b4ck5p4c3/lambium/README.md

# Lambium

Monorepo for weird building control and automation devices we built in B4CKSP4CE.

## License

- Hardware designs are licensed under the CERN Open Hardware Licence Version 2 - Strongly Reciprocal (CERN-OHL-S-2.0).
- Software is licensed under the Mozilla Public License 2.0.
