b4ck5p4c3/lambium/LAM-4I4O/hardware/LAM-4I4O-REVC/LAM-4I4O-REVC.pdf

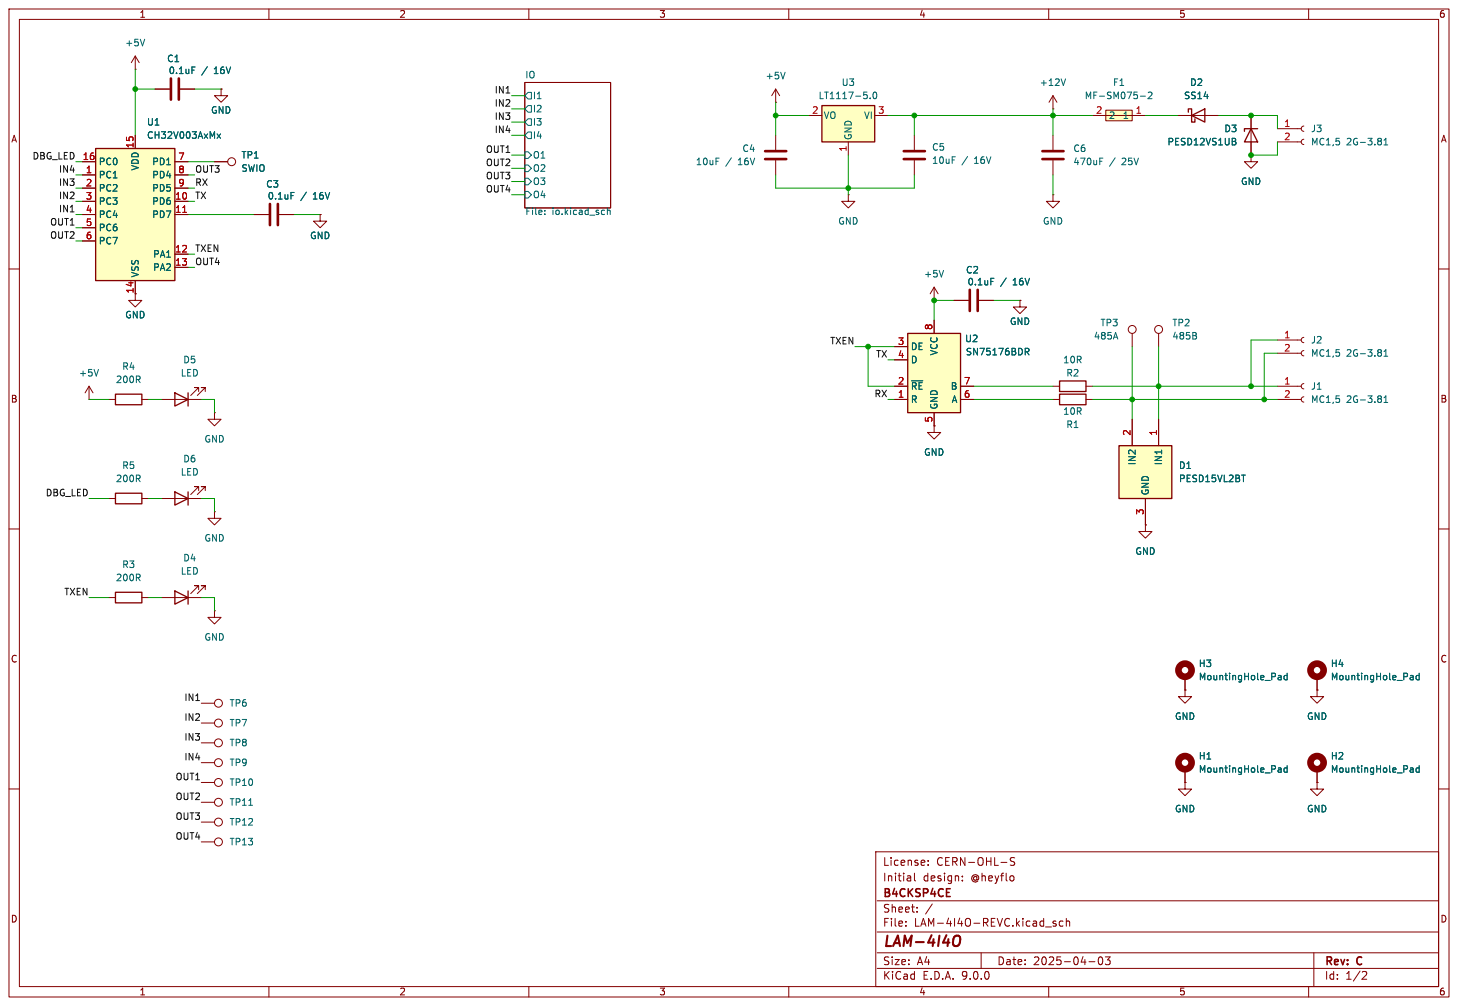
[picture p1: page 1]

License: CERN-OHL-S
Initial design: @heyflo
File: LAM-4I4O-REVC.kicad_sch Sheet: / B4CKSP4CE

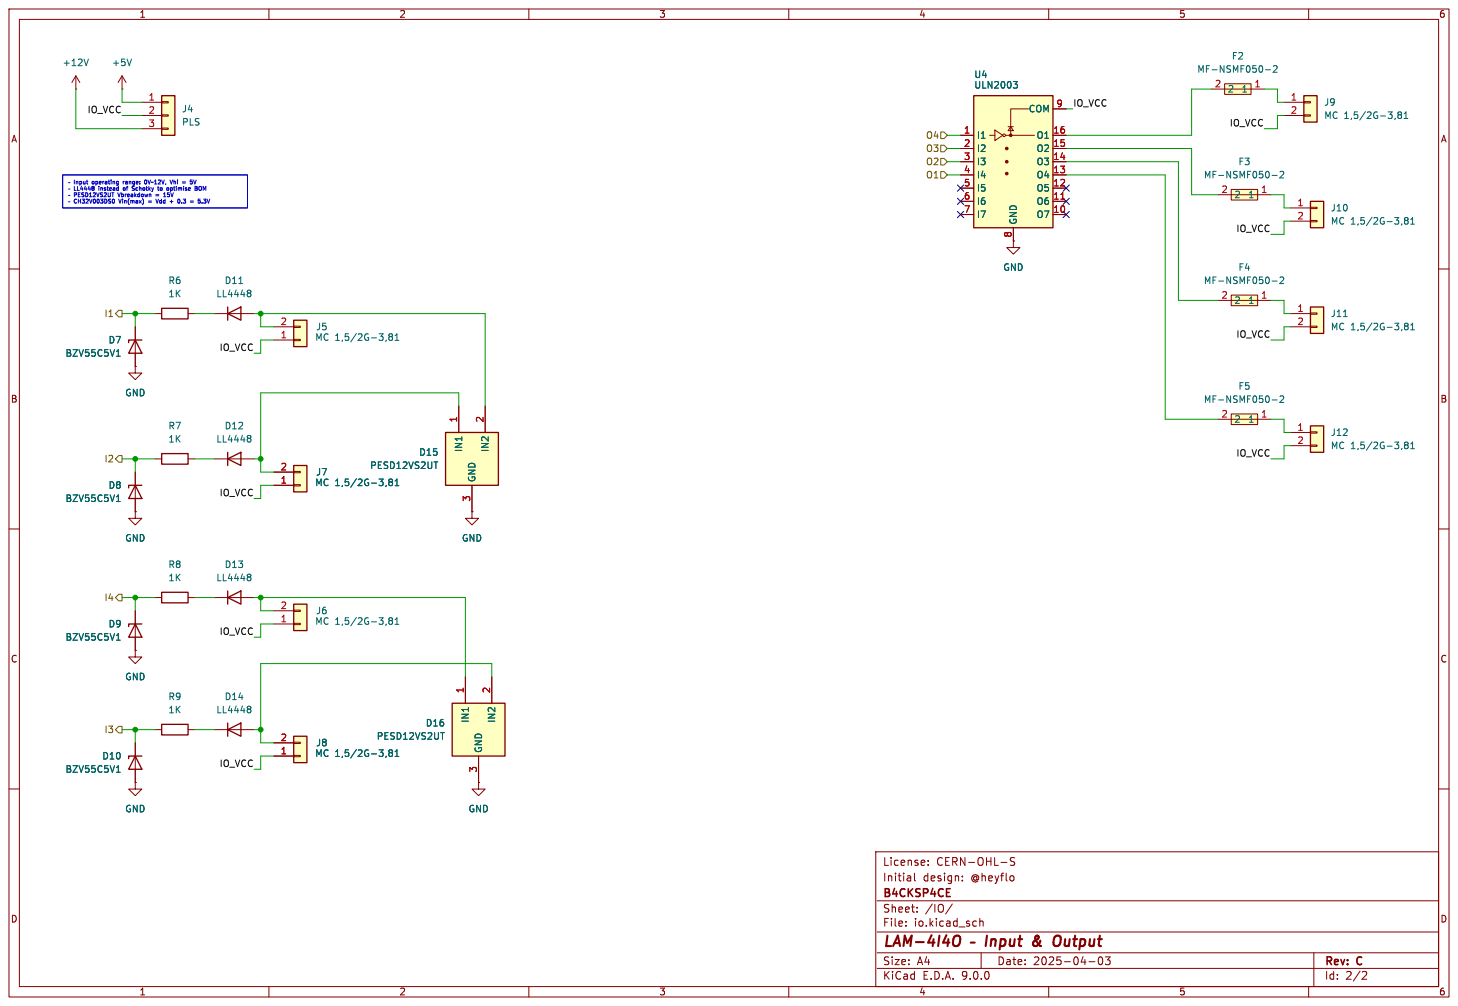
[picture p2: page 2]
