b4ck5p4c3/lambium/LAM-ZB-ROUTER/LAM-ZB-ROUTER.kicad_pcb

## KiCad design LAM-ZB-ROUTER/LAM-ZB-ROUTER.kicad_pcb (2025-06-15)

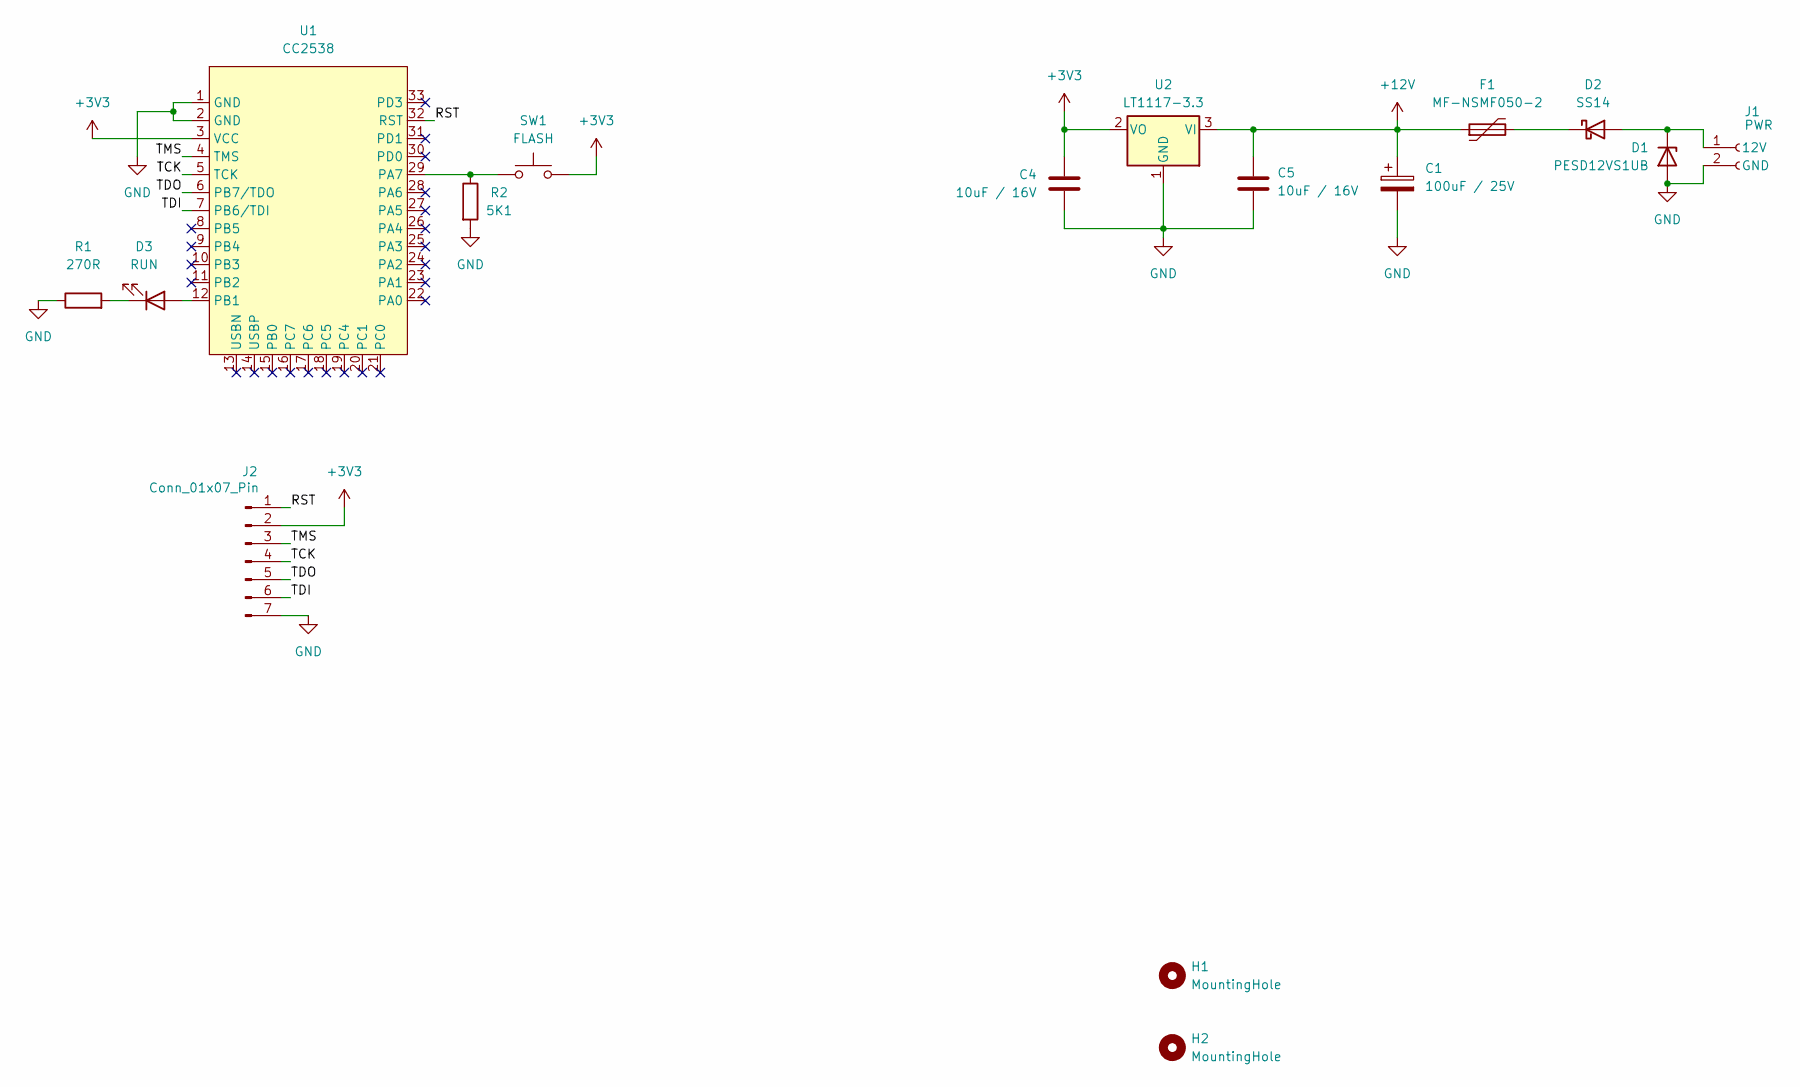
[picture p3: schematic LAM-ZB-ROUTER.kicad_sch, Lambium ZigBee Router]

Parts:
C1: 100uF / 25V; CP_Radial_D6.3mm_P2.50mm
C4, C5: 10uF / 16V; C_0805_2012Metric
D1: PESD12VS1UB; D_SOD-523
D2: SS14; D_SMA
D3: RUN; LED_1206_3216Metric
F1: MF-NSMF050-2; Fuse_1206_3216Metric
H1, H2: MountingHole; MountingHole_3.2mm_M3_ISO7380
J1: PWR; PhoenixContact_MC_1,5_2-G-3.81_1x02_P3.81mm_Horizontal
J2: Conn_01x07_Pin; PinHeader_1x07_P2.54mm_Vertical
R1: 270R; R_0805_2012Metric
R2: 5K1; R_0805_2012Metric
SW1: FLASH; SW_Tactile_SPST_NO_Straight_CK_PTS636Sx25SMTRLFS
U1: CC2538; RF_Module_CC2538
U2: LT1117-3.3; SOT-223-3_TabPin2

Connections:
+3V3: C4.1, J2.2, SW1.2, U1.3 (VCC), U2.2 (VO)
+12V: C1.1, C5.1, F1.1, U2.3 (VI)
/RST: J2.1, U1.32 (RST)
/TCK: J2.4, U1.5 (TCK)
/TDI: J2.6, U1.7 (PB6/TDI)
/TDO: J2.5, U1.6 (PB7/TDO)
/TMS: J2.3, U1.4 (TMS)
GND: C1.2, C4.2, C5.2, D1.2 (A), J1.2 (GND), J2.7, R1.1, R2.2, U1.1 (GND), U1.2 (GND), U2.1 (GND)
unnamed: D1.1 (K), D2.2 (A), J1.1 (12V)
unnamed: D2.1 (K), F1.2
unnamed: D3.2 (A), U1.12 (PB1)
unnamed: D3.1 (K), R1.2
unnamed: R2.1, SW1.1, U1.29 (PA7)

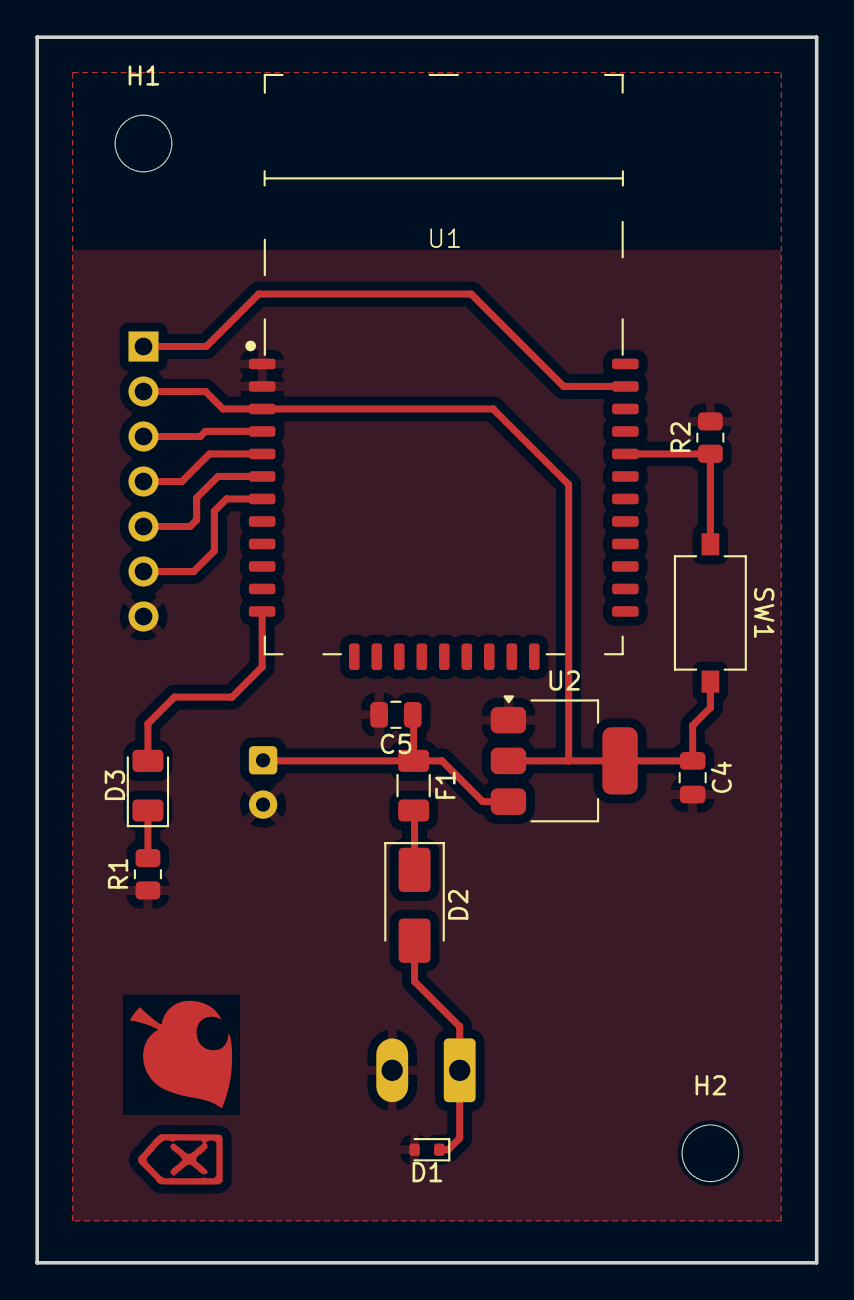
[picture p4: board LAM-ZB-ROUTER.kicad_pcb from above]

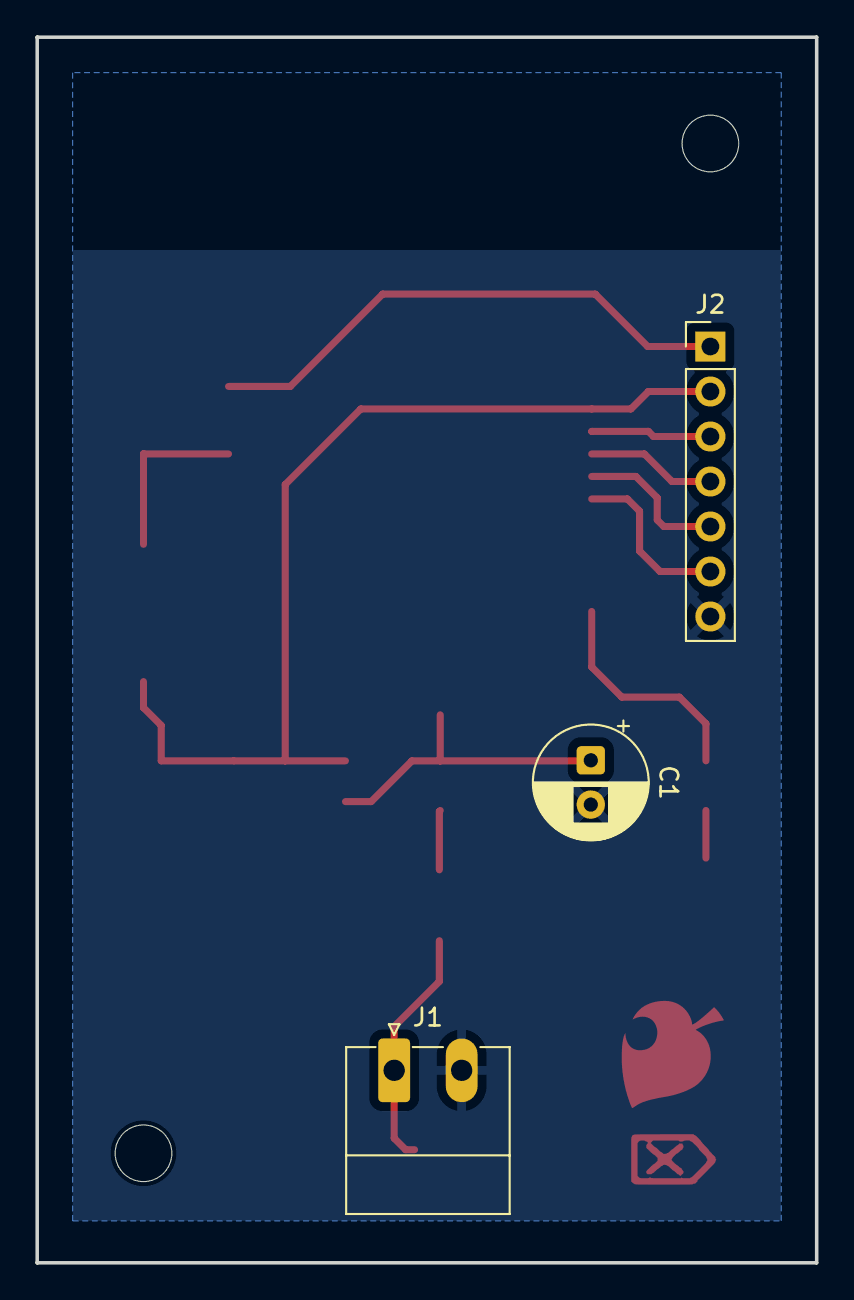
[picture p5: board LAM-ZB-ROUTER.kicad_pcb from below]

Board: 2 copper layers, 44.0 x 69.2 mm, 16 parts (3 on the bottom side), 13 nets.
