b4ck5p4c3/lambium/LAM-RPI-DMX/hardware/LAM-RPI-DMX/LAM-RPI-DMX.kicad_pcb

## KiCad design LAM-RPI-DMX/hardware/LAM-RPI-DMX/LAM-RPI-DMX.kicad_pcb (2025-06-12)

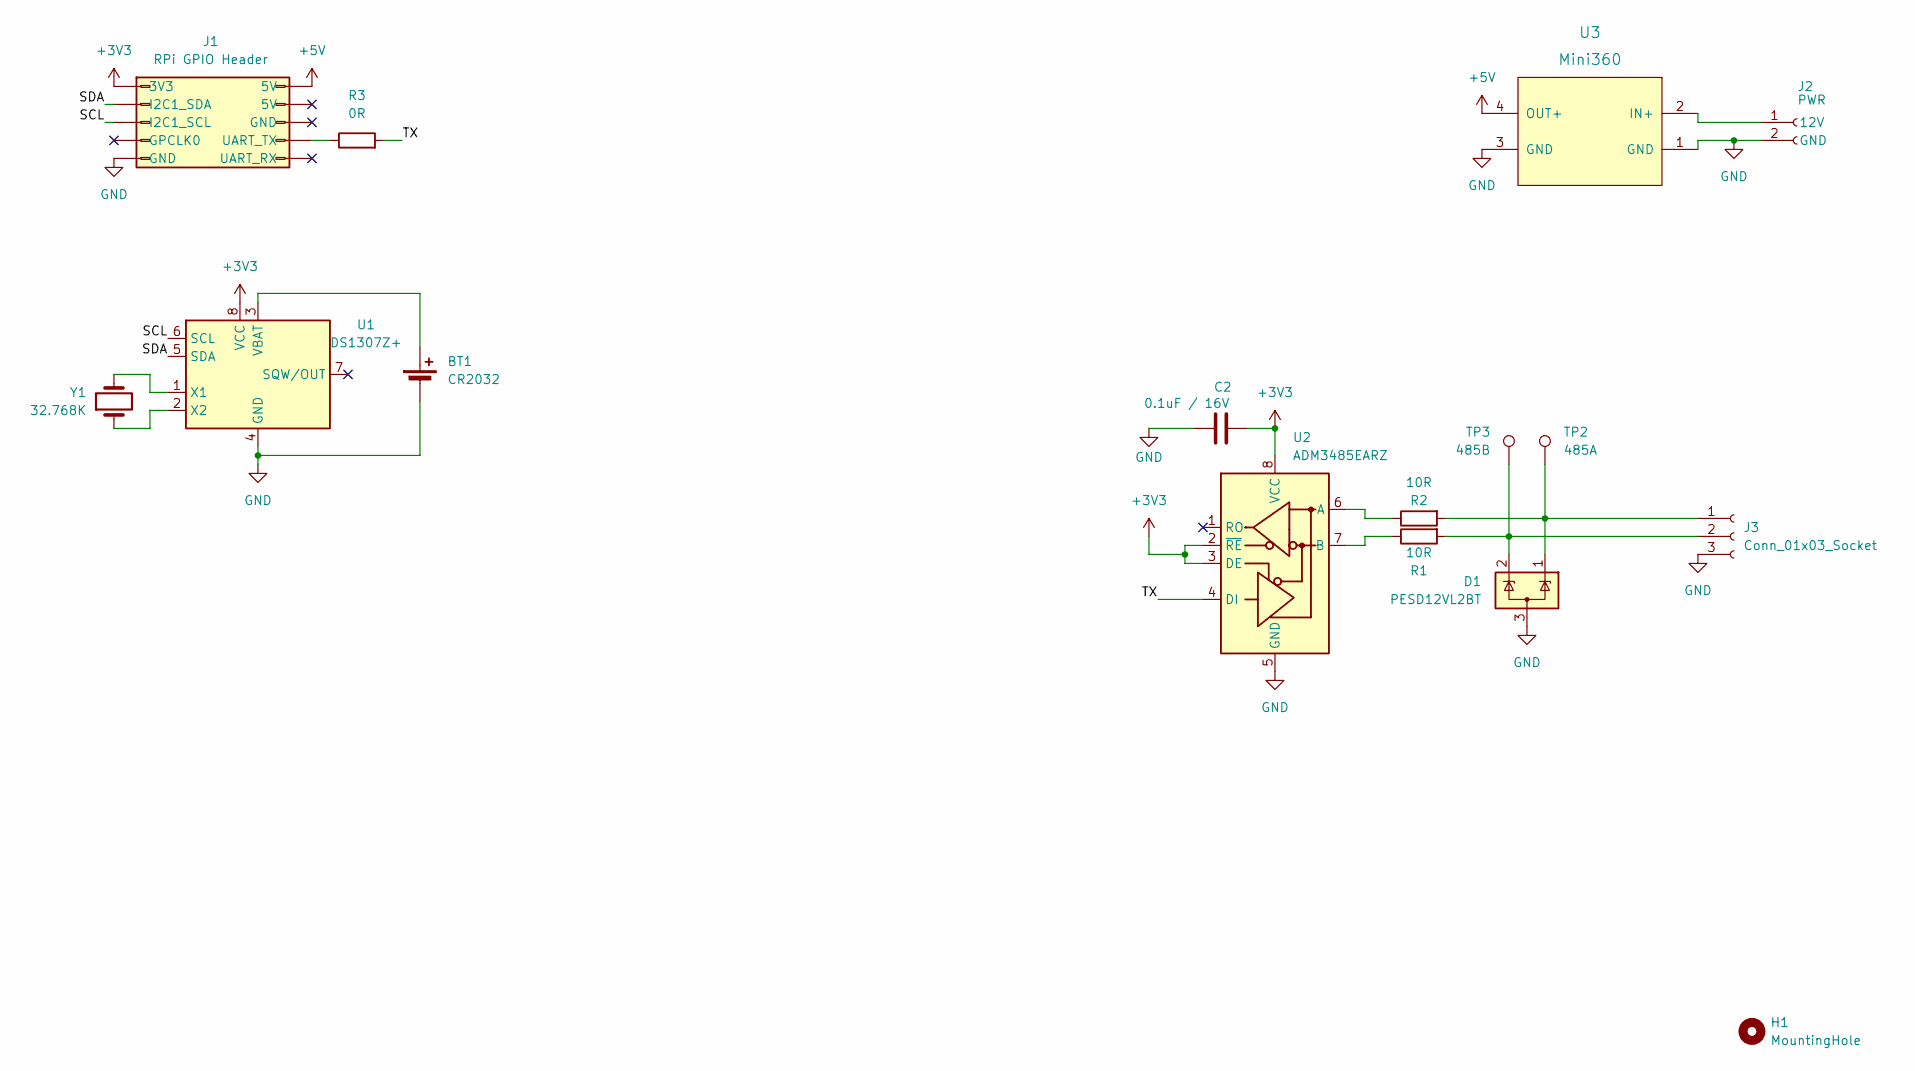
[picture p6: schematic LAM-RPI-DMX.kicad_sch, Lambium RPi DMX HAT]

Parts:
BT1: CR2032; BatteryHolder_Keystone_1058_1x2032
C2: 0.1uF / 16V; C_0805_2012Metric
D1: PESD12VL2BT; SOT-23
H1: MountingHole; MountingHole_3.2mm_M3
J1: RPi GPIO Header; PinSocket_2x05_P2.54mm_Vertical
J2: PWR; PhoenixContact_MC_1,5_2-G-3.81_1x02_P3.81mm_Horizontal
J3: Conn_01x03_Socket; PhoenixContact_MC_1,5_3-G-3.81_1x03_P3.81mm_Horizontal
R1, R2: 10R; R_0805_2012Metric
R3: 0R; R_1206_3216Metric
TP2: 485A; TestPoint_Pad_D1.0mm
TP3: 485B; TestPoint_Pad_D1.0mm
U1: DS1307Z+; SOIC-8_3.9x4.9mm_P1.27mm
U2: ADM3485EARZ; SOIC-8_3.9x4.9mm_P1.27mm
U3: Mini360; Module_Mini360
Y1: 32.768K; Crystal_SMD_3215-2Pin_3.2x1.5mm

Connections:
+3V3: C2.2, J1.1 (3V3), U1.8 (VCC), U2.2 (~RE), U2.3 (DE), U2.8 (VCC)
+5V: J1.2 (5V), U3.4 (OUT+)
/SCL: J1.5 (I2C1_SCL), U1.6 (SCL)
/SDA: J1.3 (I2C1_SDA), U1.5 (SDA)
/TX: R3.2, U2.4 (DI)
GND: BT1.2 (-), C2.1, D1.3 (A), J1.9 (GND), J2.2 (GND), J3.3, U1.4 (GND), U2.5 (GND), U3.1 (GND), U3.3 (GND)
unnamed: BT1.1 (+), U1.3 (VBAT)
unnamed: J1.8 (UART_TX), R3.1
unnamed: J2.1 (12V), U3.2 (IN+)
unnamed: D1.1 (K), J3.1, R2.2, TP2.1
unnamed: D1.2 (K), J3.2, R1.2, TP3.1
unnamed: U1.1 (X1), Y1.2
unnamed: U1.2 (X2), Y1.1
unnamed: R2.1, U2.6 (A)
unnamed: R1.1, U2.7 (B)

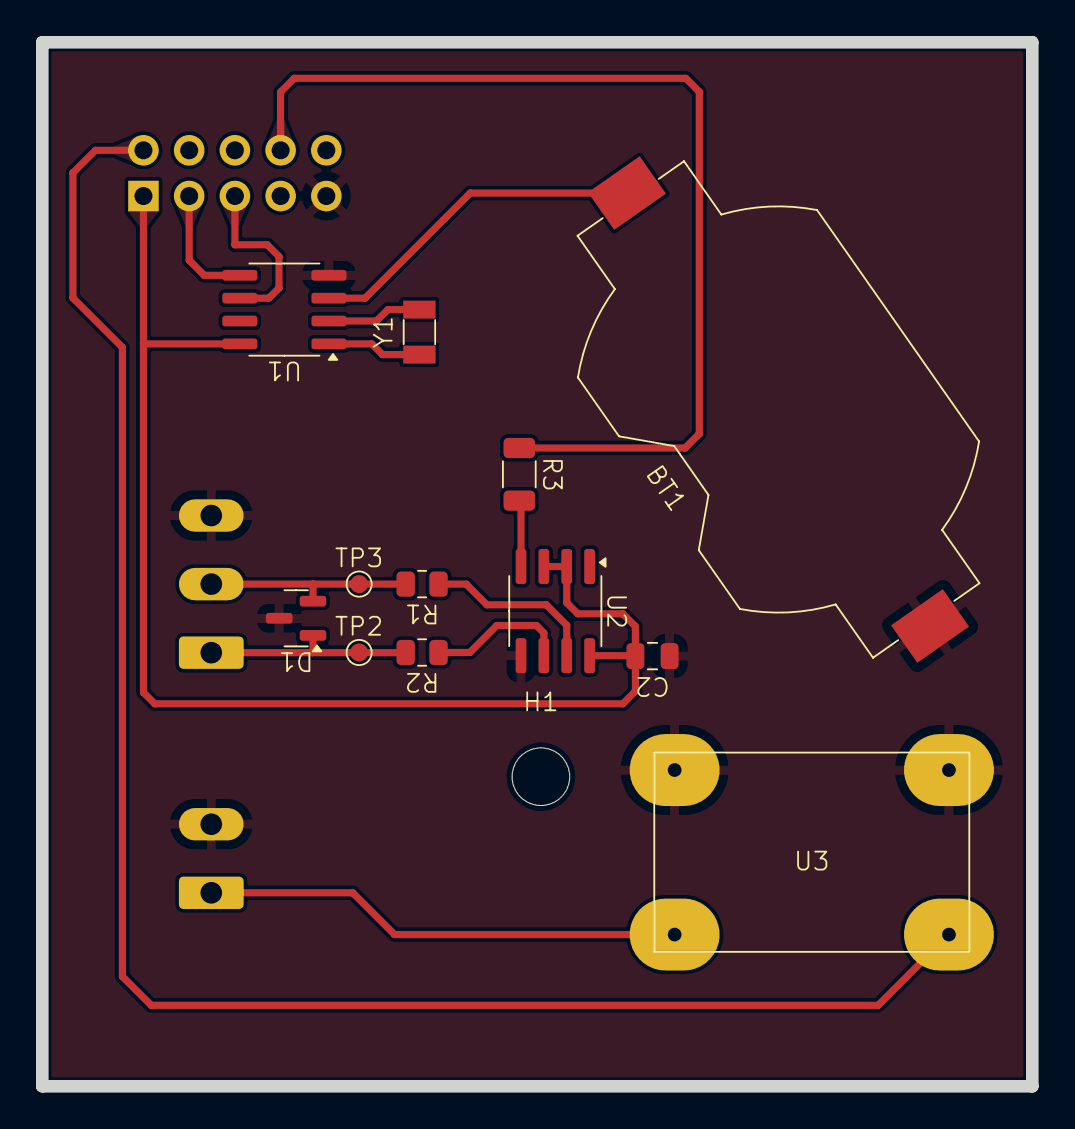
[picture p7: board LAM-RPI-DMX.kicad_pcb from above]

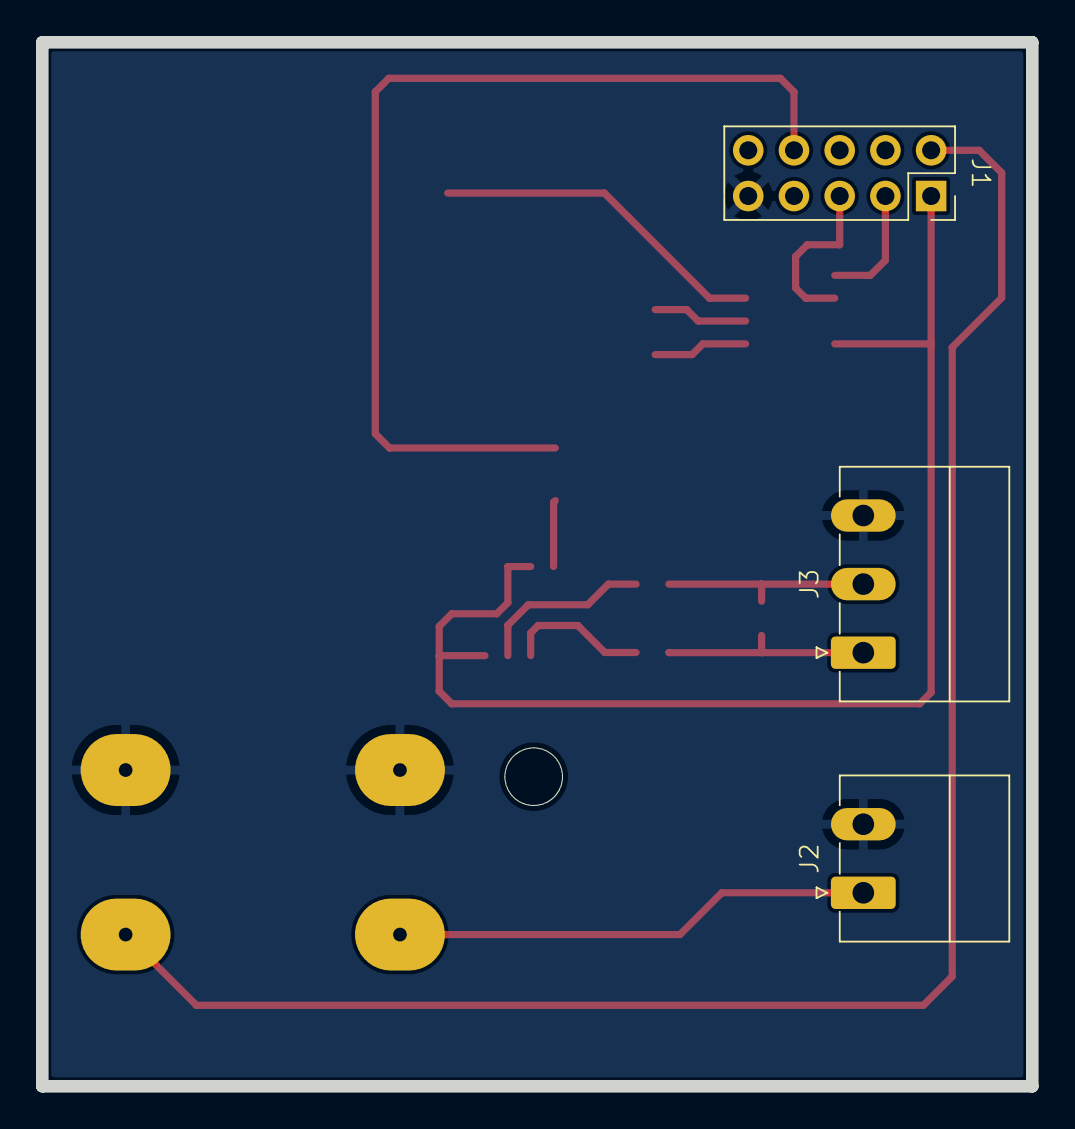
[picture p8: board LAM-RPI-DMX.kicad_pcb from below]

Board: 2 copper layers, 55.0 x 58.0 mm, 16 parts (3 on the bottom side), 15 nets.
