b4ck5p4c3/lambium/LAM-4I4O/hardware/LAM-4I4O-REVB/LAM-MEW-G3.kicad_pcb

## KiCad design LAM-4I4O/hardware/LAM-4I4O-REVB/LAM-MEW-G3.kicad_pcb (2025-04-03, an earlier design)

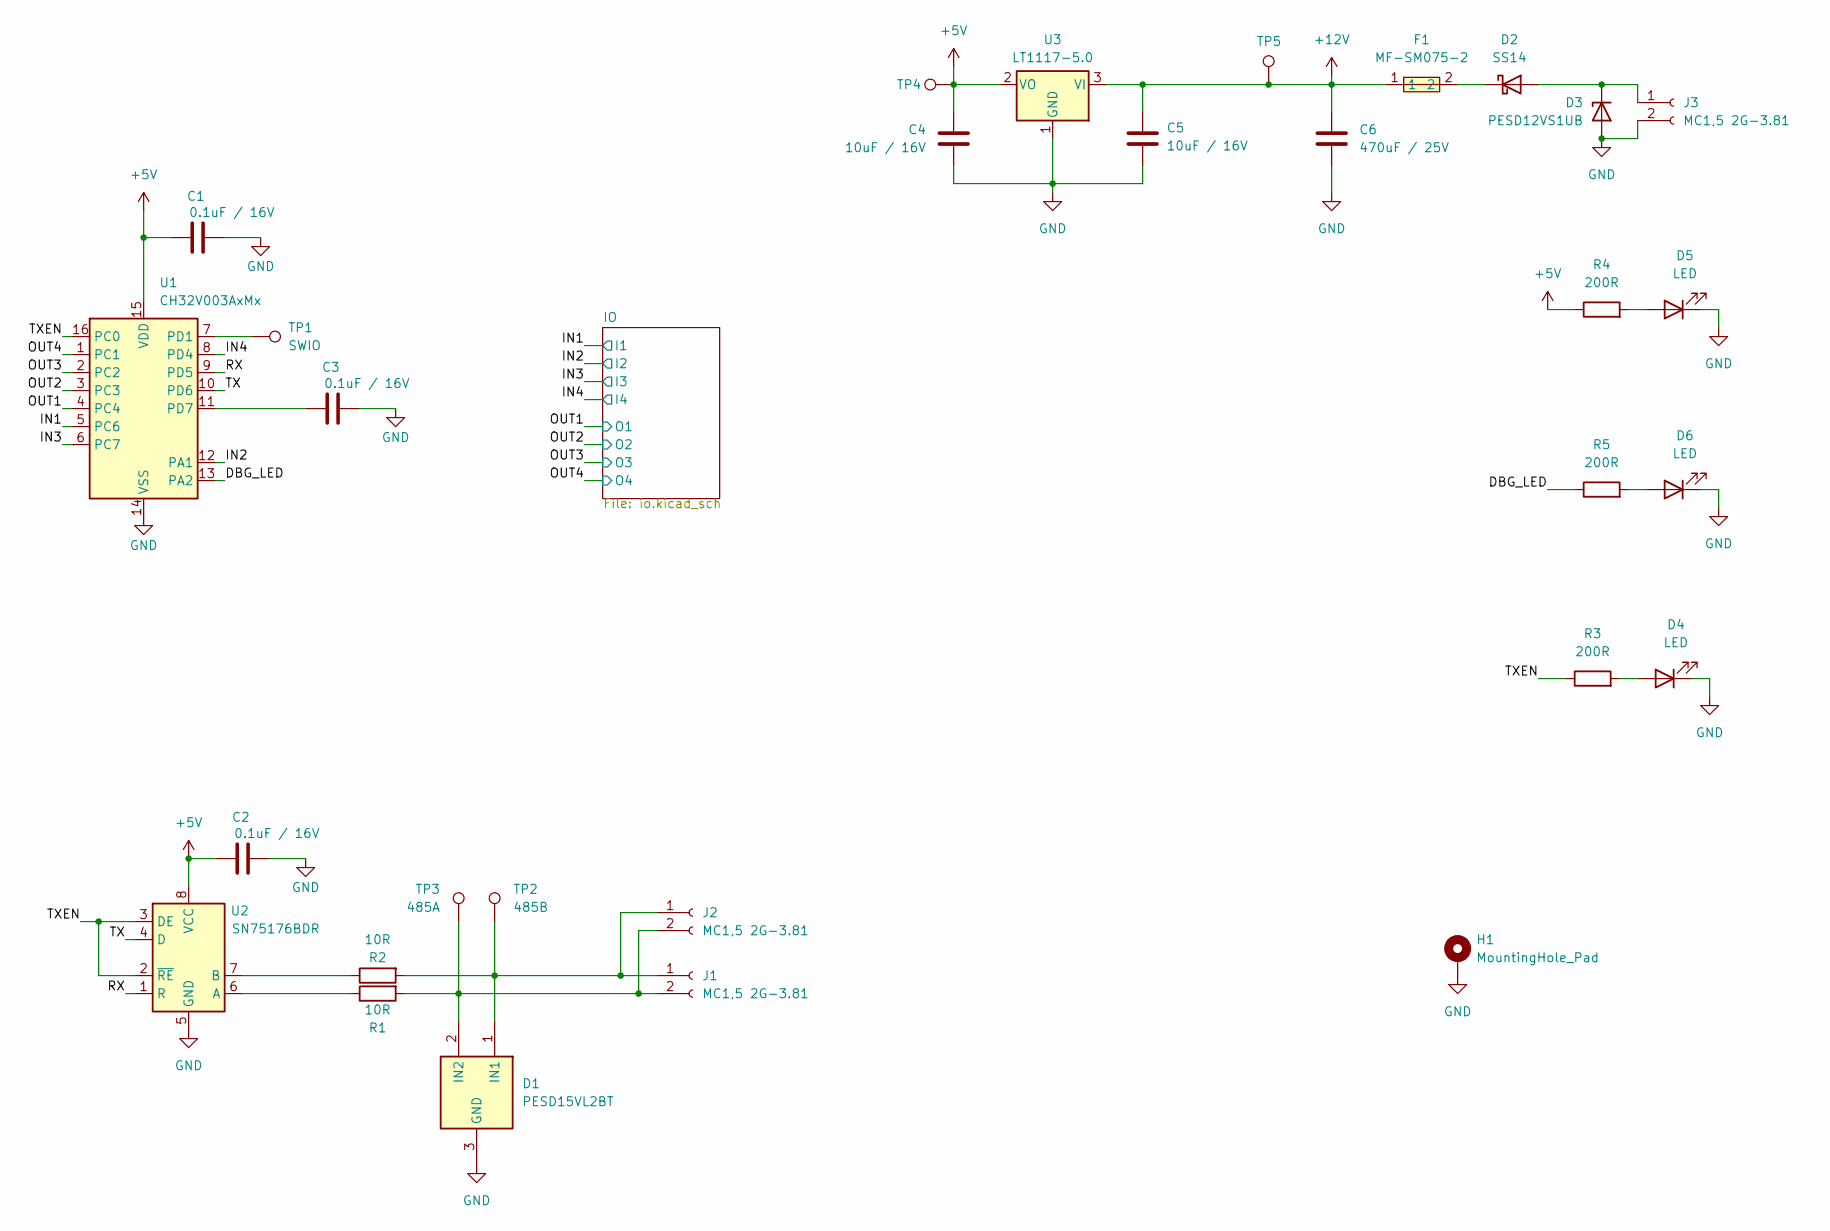
[picture p13: schematic LAM-MEW-G3.kicad_sch]

Parts:
C1, C2, C3: 0.1uF / 16V; C_0805_2012Metric
C4, C5: 10uF / 16V; C_0805_2012Metric
C6: 470uF / 25V; CP_Elec_6.3x5.9
D1: PESD15VL2BT; SOT-23; Mouser Part Number 771-PESD15VS2UT-T/R
D2: SS14; D_SMA
D3: PESD12VS1UB; D_SOD-523
D4, D5, D6: LED; LED_1206_3216Metric_ReverseMount_Hole1.8x2.4mm
F1: MF-SM075-2; FUSE-SMD_L7.4-W5.4
H1: MountingHole_Pad; MountingHole_3.2mm_M3_DIN965_Pad_TopOnly
J1, J2, J3: MC1,5 2G-3.81; PhoenixContact_MC_1,5_2-G-3.81_1x02_P3.81mm_Horizontal
R1, R2: 10R; R_0805_2012Metric
R3, R4, R5: 200R; R_0805_2012Metric
TP1: SWIO; TestPoint_Pad_D2.5mm
TP2: 485B; TestPoint_Pad_D2.5mm
TP3: 485A; TestPoint_Pad_D2.5mm
TP4: 5V; TestPoint_Pad_D2.5mm
TP5: 12V; TestPoint_Pad_D2.5mm
U1: CH32V003AxMx; SOP-16_3.9x9.9mm_P1.27mm
U2: SN75176BDR; SOIC-8_3.9x4.9mm_P1.27mm
U3: LT1117-5.0; SOT-223

Connections:
+5V: C1.2, C2.2, C4.1, R4.1, TP4.1, U1.15 (VDD), U2.8 (VCC), U3.2 (VO); also elsewhere on the board
+12V: C5.1, C6.1, F1.1, TP5.1, U3.3 (VI); also elsewhere on the board
/DBG_LED: R5.1, U1.13 (PA2)
/IN1: U1.5 (PC6); also elsewhere on the board
/IN2: U1.12 (PA1); also elsewhere on the board
/IN3: U1.6 (PC7); also elsewhere on the board
/IN4: U1.8 (PD4); also elsewhere on the board
/OUT1: U1.4 (PC4); also elsewhere on the board
/OUT2: U1.3 (PC3); also elsewhere on the board
/OUT3: U1.2 (PC2); also elsewhere on the board
/OUT4: U1.1 (PC1); also elsewhere on the board
/RX: U1.9 (PD5), U2.1 (R)
/TX: U1.10 (PD6), U2.4 (D)
/TXEN: R3.1, U1.16 (PC0), U2.2 (~RE), U2.3 (DE)
GND: C1.1, C2.1, C3.1, C4.2, C5.2, C6.2, D1.3 (GND), D3.2 (A), D4.1 (K), D5.1 (K), D6.1 (K), H1.1, J3.2, U1.14 (VSS), U2.5 (GND), U3.1 (GND); also elsewhere on the board
unnamed: D1.1 (IN1), J1.1, J2.1, R2.2, TP2.1
unnamed: D1.2 (IN2), J1.2, J2.2, R1.2, TP3.1
unnamed: D2.2 (A), D3.1 (K), J3.1
unnamed: D2.1 (K), F1.2
unnamed: D4.2 (A), R3.2
unnamed: D5.2 (A), R4.2
unnamed: D6.2 (A), R5.2
unnamed: TP1.1, U1.7 (PD1)
unnamed: C3.2, U1.11 (PD7)
unnamed: R1.1, U2.6 (A)
unnamed: R2.1, U2.7 (B)

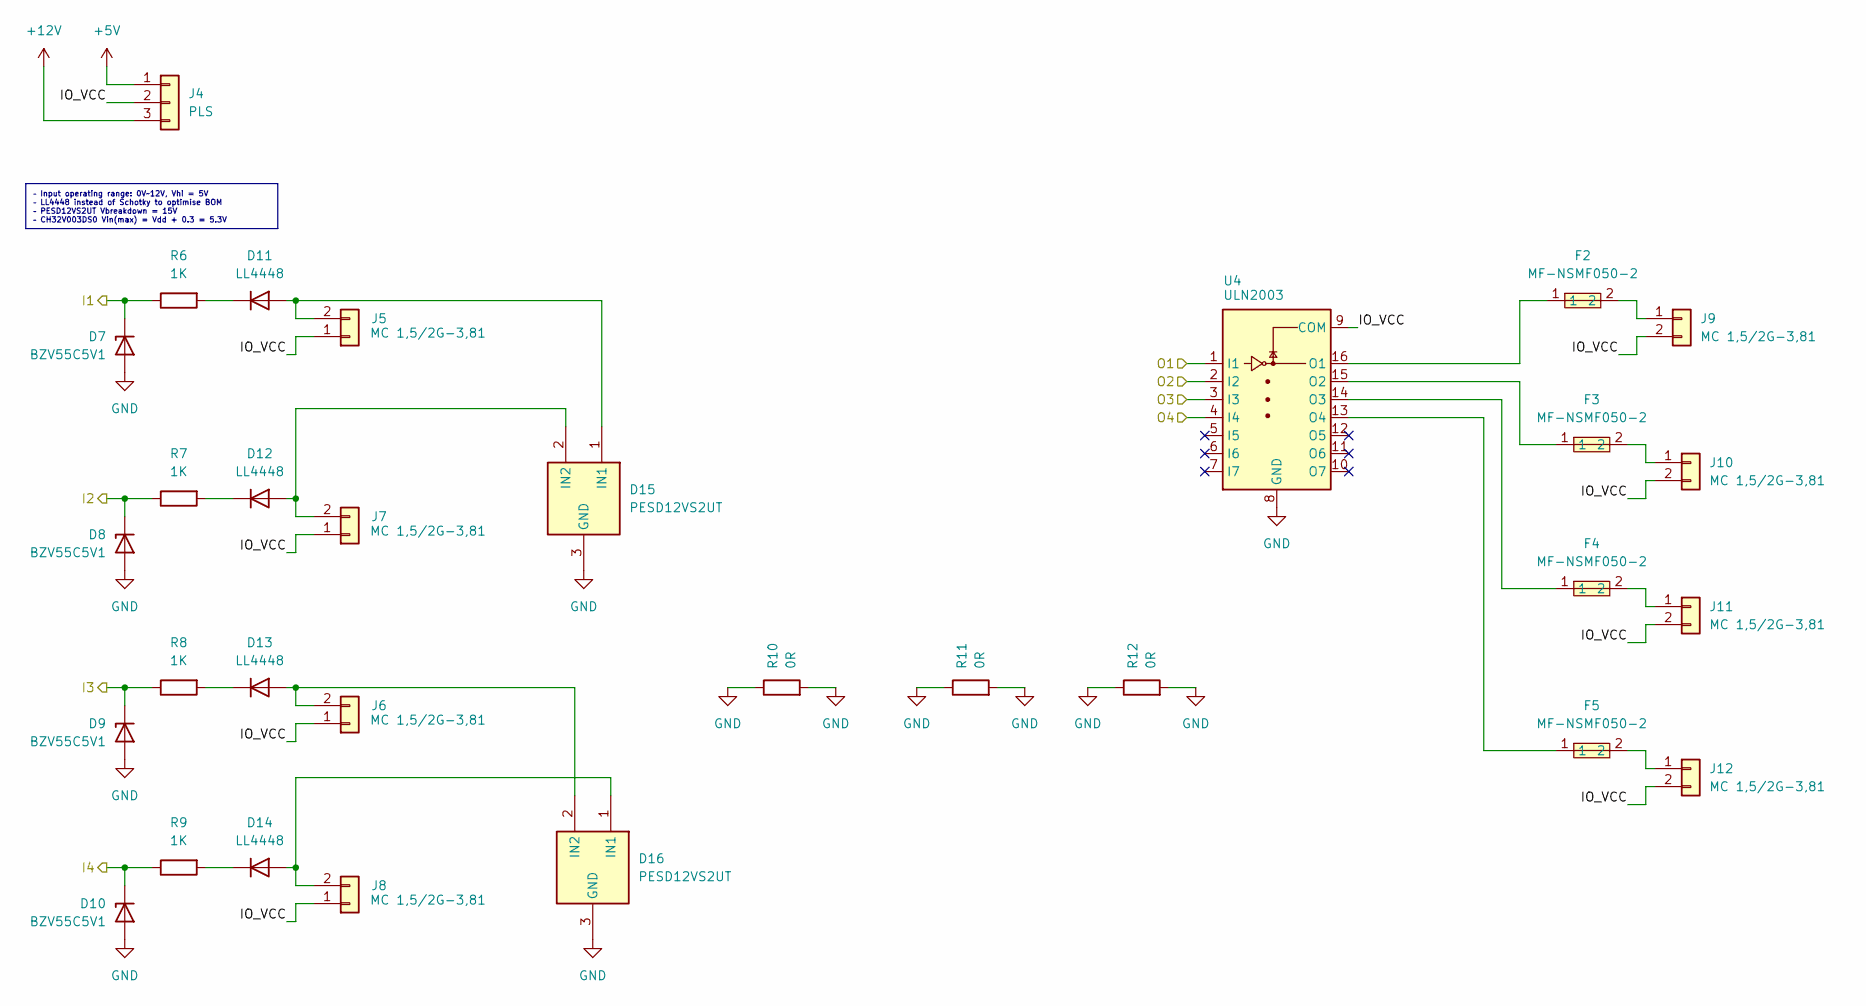
[picture p14: schematic io.kicad_sch, LAM-MEW-G3]

Parts:
D7, D8, D9, D10: BZV55C5V1; D_MiniMELF
D11, D12, D13, D14: LL4448; D_MiniMELF
D15, D16: PESD12VS2UT; SOT-23; Mouser Part Number 771-PESD15VS2UT-T/R
F2, F3, F4, F5: MF-NSMF050-2; Fuse_1206_3216Metric; LCSC Part C75464
J4: PLS; PinHeader_1x03_P2.54mm_Vertical
J5, J6, J7, J8, J9, J10, J11, J12: MC 1,5/2G-3,81; PhoenixContact_MC_1,5_2-G-3.81_1x02_P3.81mm_Horizontal
R6, R7, R8, R9: 1K; R_0805_2012Metric
R10, R11, R12: 0R; R_1206_3216Metric
U4: ULN2003; SOIC-16_3.9x9.9mm_P1.27mm

Connections:
+5V: J4.1; also elsewhere on the board
+12V: J4.3; also elsewhere on the board
/IN1: D7.1 (K), R6.1; also elsewhere on the board
/IN2: D8.1 (K), R7.1; also elsewhere on the board
/IN3: D9.1 (K), R8.1; also elsewhere on the board
/IN4: D10.1 (K), R9.1; also elsewhere on the board
/IO/IO_VCC: J4.2, J5.1, J6.1, J7.1, J8.1, J9.2, J10.2, J11.2, J12.2, U4.9 (COM)
/OUT1: U4.1 (I1); also elsewhere on the board
/OUT2: U4.2 (I2); also elsewhere on the board
/OUT3: U4.3 (I3); also elsewhere on the board
/OUT4: U4.4 (I4); also elsewhere on the board
GND: D7.2 (A), D8.2 (A), D9.2 (A), D10.2 (A), D15.3 (GND), D16.3 (GND), R10.1, R10.2, R11.1, R11.2, R12.1, R12.2, U4.8 (GND); also elsewhere on the board
unnamed: D11.2 (A), D15.1 (IN1), J5.2
unnamed: D11.1 (K), R6.2
unnamed: D12.2 (A), D15.2 (IN2), J7.2
unnamed: D12.1 (K), R7.2
unnamed: D13.2 (A), D16.2 (IN2), J6.2
unnamed: D13.1 (K), R8.2
unnamed: D14.2 (A), D16.1 (IN1), J8.2
unnamed: D14.1 (K), R9.2
unnamed: F2.2, J9.1
unnamed: F3.2, J10.1
unnamed: F4.2, J11.1
unnamed: F5.2, J12.1
unnamed: F2.1, U4.16 (O1)
unnamed: F3.1, U4.15 (O2)
unnamed: F4.1, U4.14 (O3)
unnamed: F5.1, U4.13 (O4)

Notes on the sheet:
– Input operating range: 0V~12V, Vhi = 5V – LL4448 instead of Schotky to optimise BOM – PESD12VS2UT Vbreakdown = 15V – CH32V003DS0 Vin(max) = Vdd + 0.3 = 5.3V

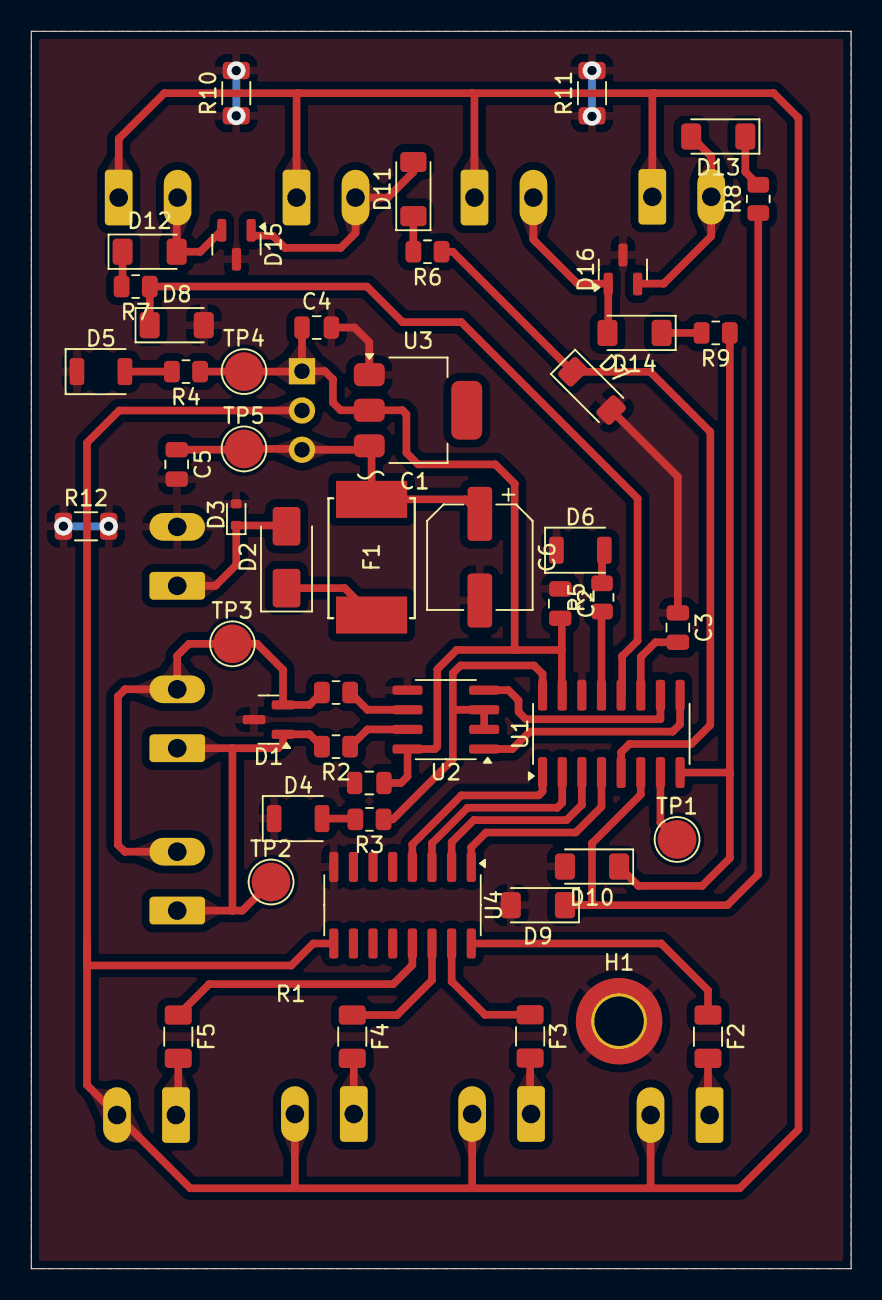
[picture p15: board LAM-MEW-G3.kicad_pcb from above]

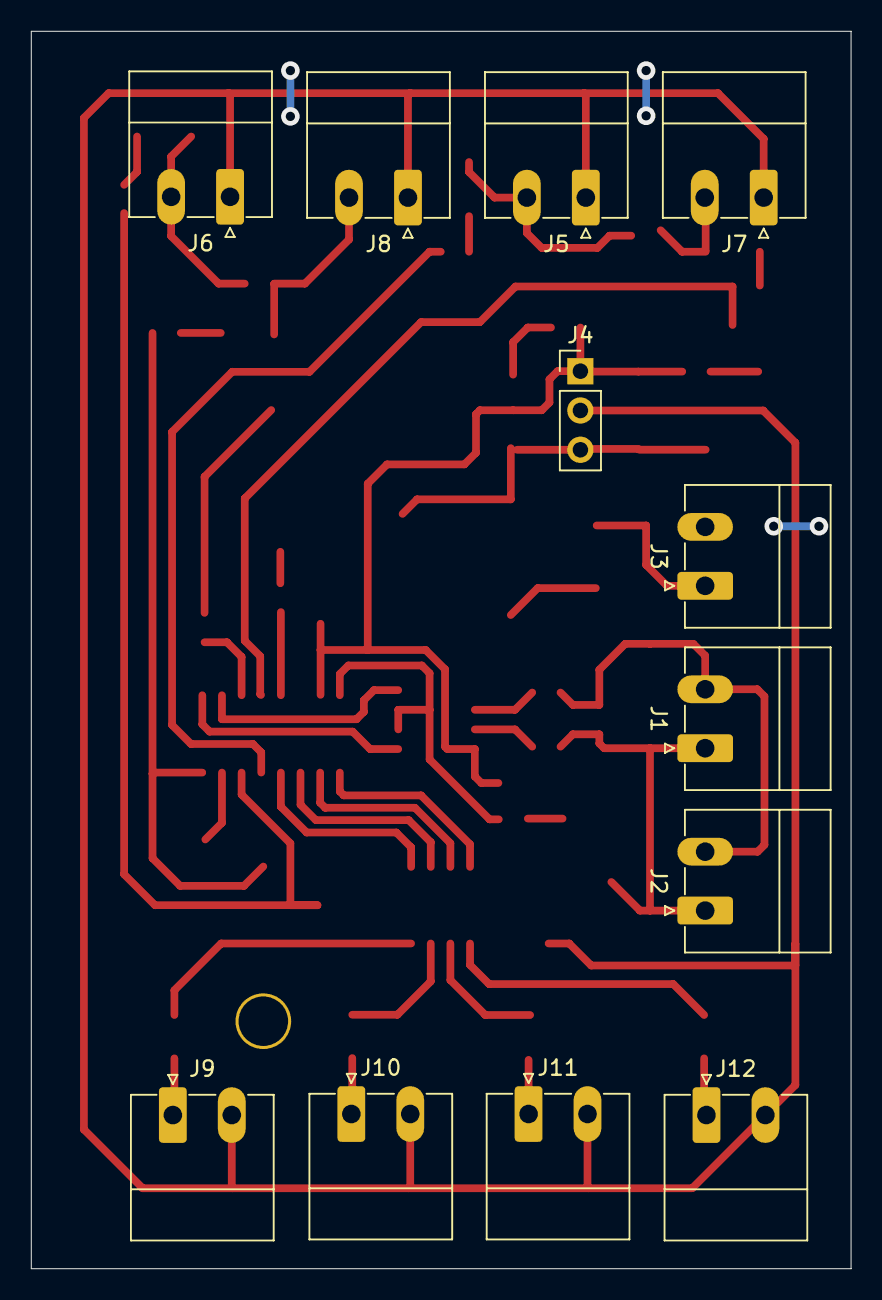
[picture p16: board LAM-MEW-G3.kicad_pcb from below]

Board: 2 copper layers, 53.0 x 80.0 mm, 61 parts (12 on the bottom side), 43 nets.
