b4ck5p4c3/lambium/LAM-4I4O/hardware/LAM-4I4O-REVA/lam-4i4o.kicad_pcb

## KiCad design LAM-4I4O/hardware/LAM-4I4O-REVA/lam-4i4o.kicad_pcb (2024-11-10, an earlier design)

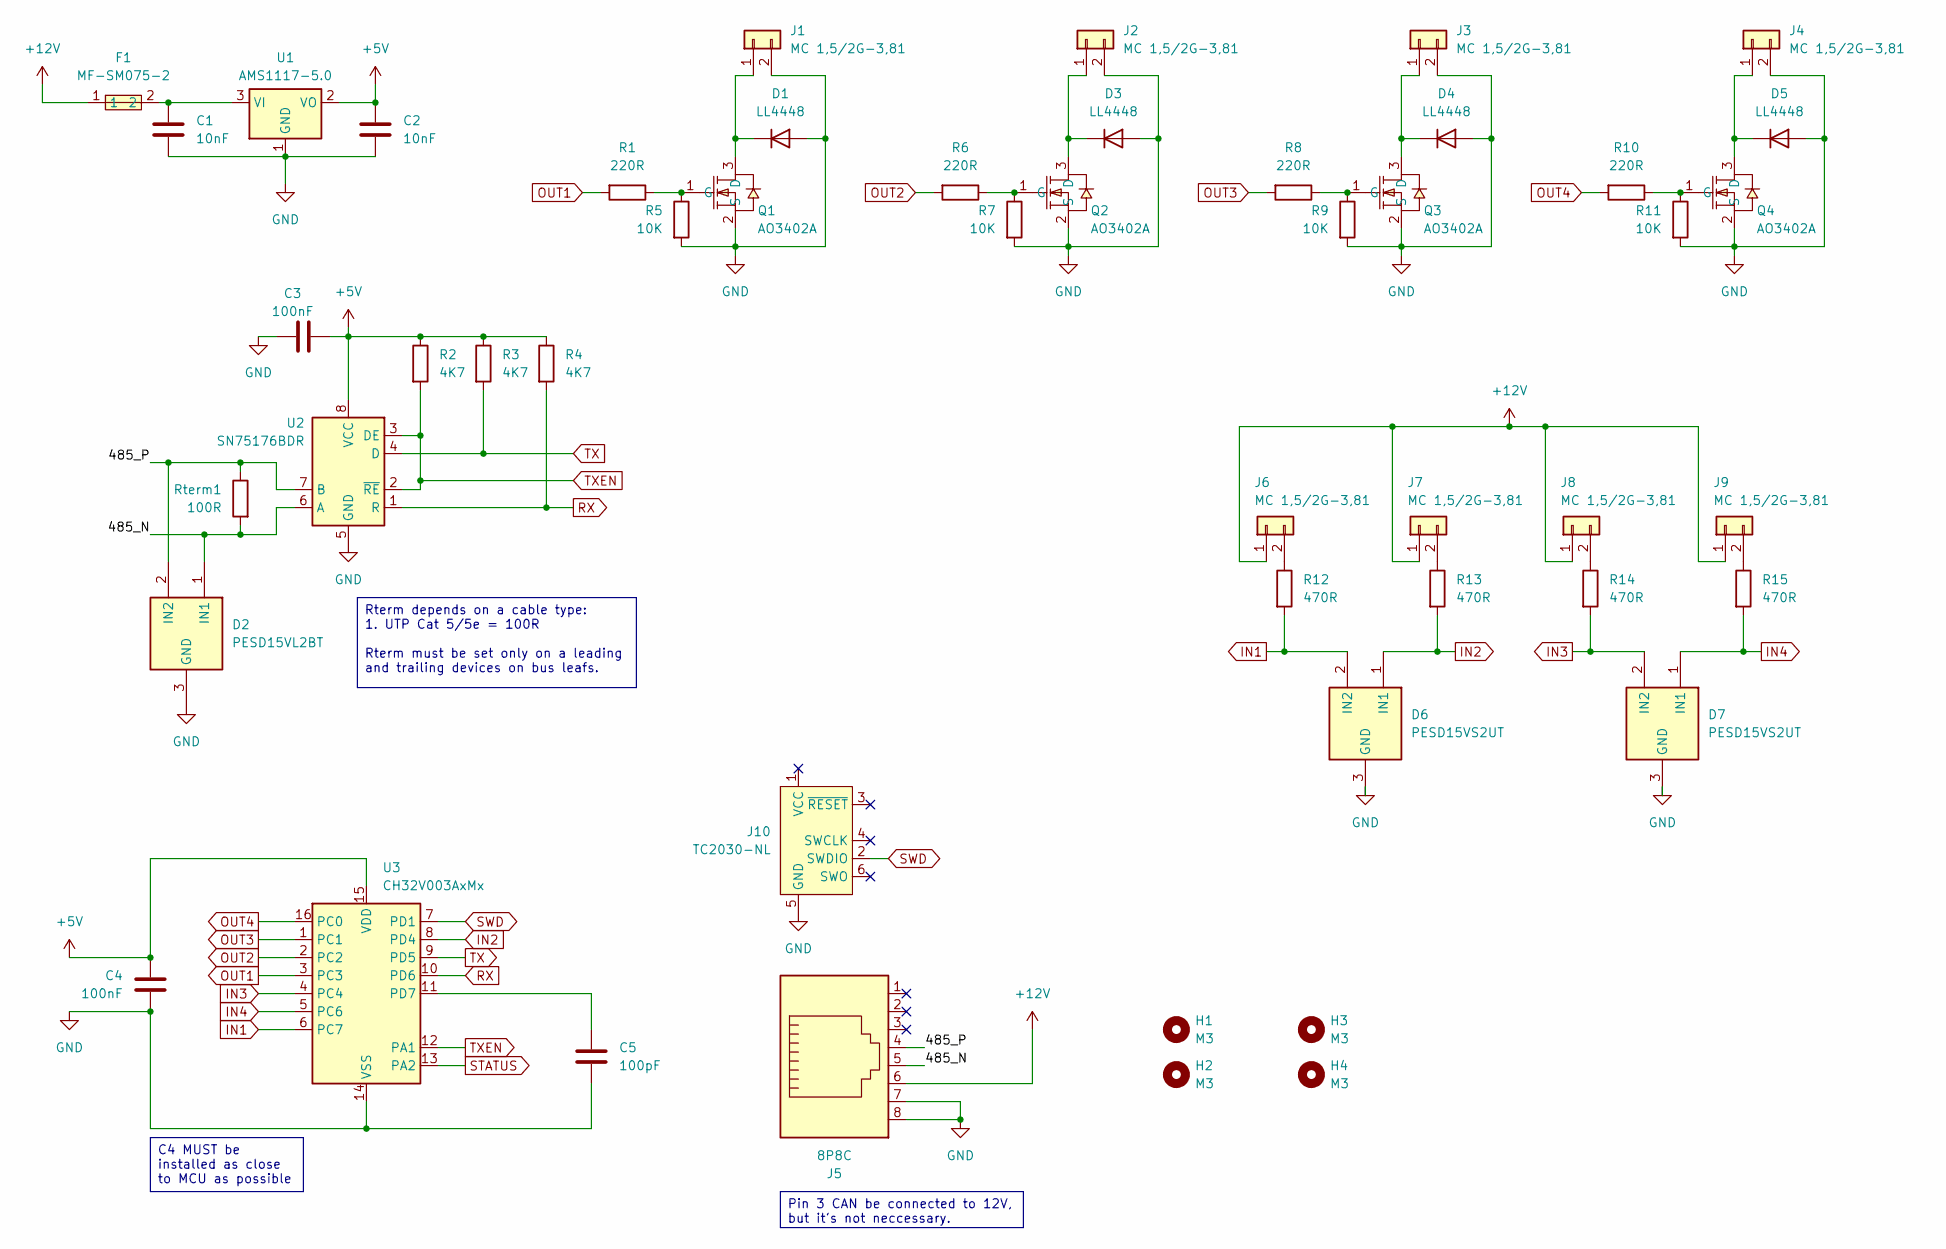
[picture p17: schematic lam-4i4o.kicad_sch, Lamium]

Parts:
C1, C2: 10nF; C_1206_3216Metric
C3, C4: 100nF; C_1206_3216Metric
C5: 100pF; C_1206_3216Metric
D1, D3, D4, D5: LL4448; D_MiniMELF
D2: PESD15VL2BT; SOT-23; Mouser Part Number 771-PESD15VS2UT-T/R
D6, D7: PESD15VS2UT; SOT-23; Mouser Part Number 771-PESD15VS2UT-T/R
F1: MF-SM075-2; FUSE-SMD_L7.4-W5.4
H1, H2, H3, H4: M3; MountingHole_3.2mm_M3
J1, J2, J3, J4, J6, J7, J8, J9: MC 1,5/2G-3,81; PhoenixContact_MC_1,5_2-G-3.81_1x02_P3.81mm_Horizontal
J5: 8P8C; Connfly_DS1134
J10: TC2030-NL; Tag-Connect_TC2030-IDC-NL_2x03_P1.27mm_Vertical
Q1, Q2, Q3, Q4: AO3402A; SOT-23
R1, R6, R8, R10: 220R; R_1206_3216Metric
R2, R3, R4: 4K7; R_1206_3216Metric
R5, R7, R9, R11: 10K; R_1206_3216Metric
R12, R13, R14, R15: 470R; R_1206_3216Metric
Rterm1: 100R; R_1206_3216Metric
U1: AMS1117-5.0; SOT-223-3_TabPin2
U2: SN75176BDR; SOIC-8_3.9x4.9mm_P1.27mm
U3: CH32V003AxMx; SOP-16_3.9x9.9mm_P1.27mm

Connections:
+5V: C2.1, C3.2, C4.2, R2.1, R3.1, R4.1, U1.2 (VO), U2.8 (VCC), U3.15 (VDD)
+12V: F1.1, J5.6, J6.1, J7.1, J8.1, J9.1
/485_N: D2.1 (IN1), J5.5, Rterm1.2, U2.6 (A)
/485_P: D2.2 (IN2), J5.4, Rterm1.1, U2.7 (B)
GND: C1.2, C2.2, C3.1, C4.1, C5.2, D1.2 (A), D2.3 (GND), D3.2 (A), D4.2 (A), D5.2 (A), D6.3 (GND), D7.3 (GND), J1.2, J2.2, J3.2, J4.2, J5.7, J5.8, J10.5 (GND), Q1.2 (S), Q2.2 (S), Q3.2 (S), Q4.2 (S), R5.2, R7.2, R9.2, R11.2, U1.1 (GND), U2.5 (GND), U3.14 (VSS)
IN1: D6.2 (IN2), R12.2, U3.6 (PC7)
IN2: D6.1 (IN1), R13.2, U3.8 (PD4)
IN3: D7.2 (IN2), R14.2, U3.4 (PC4)
IN4: D7.1 (IN1), R15.2, U3.5 (PC6)
unnamed: D1.1 (K), J1.1, Q1.3 (D)
unnamed: D3.1 (K), J2.1, Q2.3 (D)
unnamed: D4.1 (K), J3.1, Q3.3 (D)
unnamed: D5.1 (K), J4.1, Q4.3 (D)
unnamed: J6.2, R12.1
unnamed: J7.2, R13.1
unnamed: J8.2, R14.1
unnamed: J9.2, R15.1
unnamed: Q1.1 (G), R1.1, R5.1
unnamed: Q2.1 (G), R6.1, R7.1
unnamed: Q3.1 (G), R8.1, R9.1
unnamed: Q4.1 (G), R10.1, R11.1
unnamed: C1.1, F1.2, U1.3 (VI)
unnamed: C5.1, U3.11 (PD7)
OUT1: R1.2, U3.3 (PC3)
OUT2: R6.2, U3.2 (PC2)
OUT3: R8.2, U3.1 (PC1)
OUT4: R10.2, U3.16 (PC0)
RX: R4.2, U2.1 (R), U3.10 (PD6)
STATUS: U3.13 (PA2)
SWD: J10.2 (SWDIO), U3.7 (PD1)
TX: R3.2, U2.4 (D), U3.9 (PD5)
TXEN: R2.2, U2.2 (~RE), U2.3 (DE), U3.12 (PA1)

Notes on the sheet:
C4 MUST be installed as close to MCU as possible
Pin 3 CAN be connected to 12V, but it's not neccessary.
Rterm depends on a cable type: 1. UTP Cat 5/5e = 100R Rterm must be set only on a leading and trailing devices on bus leafs.

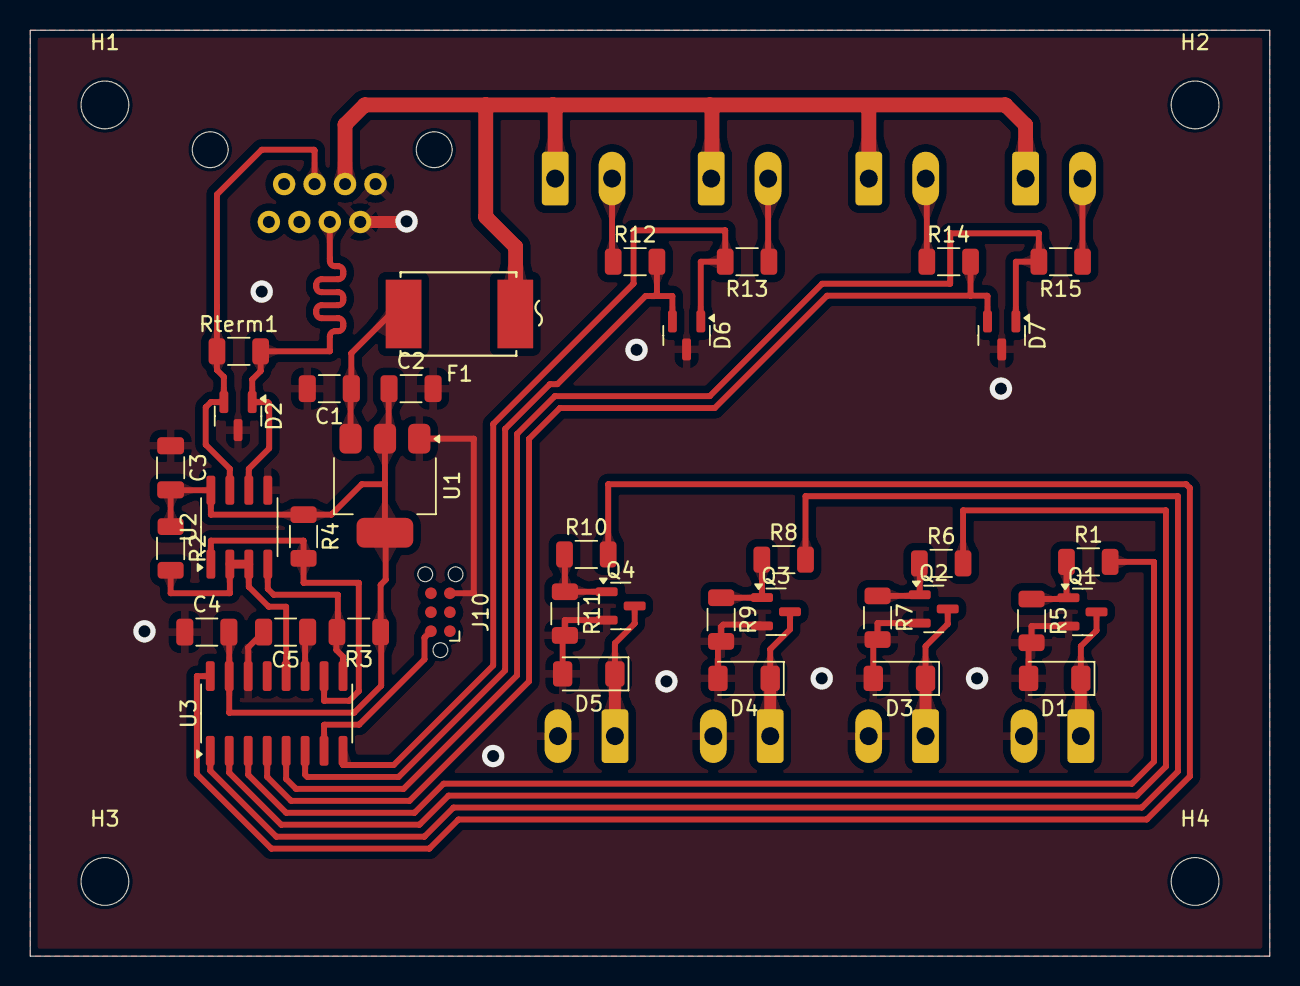
[picture p18: board lam-4i4o.kicad_pcb from above]

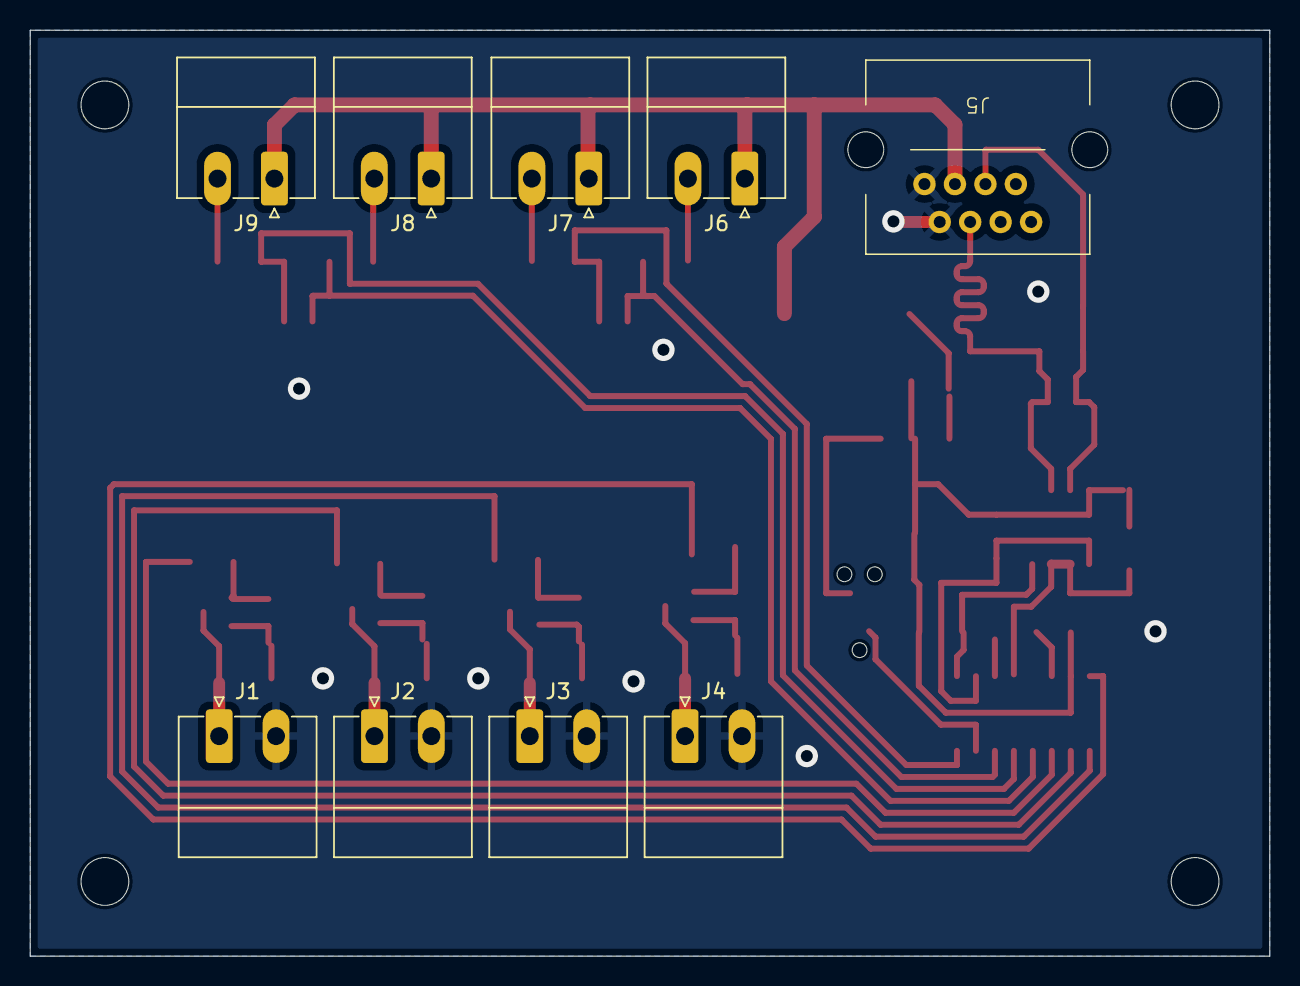
[picture p19: board lam-4i4o.kicad_pcb from below]

Board: 2 copper layers, 83.0 x 62.0 mm, 50 parts (9 on the bottom side), 31 nets.
