b4ck5p4c3/lambium/(commit log)

2024-11-10 LAM-4I4O: drafts
    [lam-4i4o.kicad_pcb, lam-4i4o.kicad_sch]
2025-04-03 feat(LAM-4I4O): add Rev B & C
    [LAM-4I4O-REVC.kicad_pcb, LAM-4I4O-REVC.kicad_sch, LAM-MEW-G3.kicad_pcb, LAM-MEW-G3.kicad_sch, io.kicad_sch, lam-4i4o.kicad_pcb, lam-4i4o.kicad_sch]
2025-04-04 fix(LAM-4I4O): RS-485 connector spacing
    [LAM-4I4O-REVC.kicad_pcb]
2025-04-04 fix(LAM-4I4O): increase trace length to 0.5mm, fix missing ground trace for single-layer manufacturing
    [LAM-4I4O-REVC.kicad_pcb]
2025-04-06 add firmware
    [LAM-4I4O-REVC.kicad_pcb]
2025-04-14 fix(LAM-4I4O): incorrect PESD12VL2BT value in RS-485
    [LAM-4I4O-REVC.kicad_sch]
2025-06-08 LAM-RPI-DMX: first draft
    [LAM-RPI-DMX.kicad_pcb, LAM-RPI-DMX.kicad_sch]
2025-06-12 LAM-RPI-DMX: Revision A
    [LAM-RPI-DMX.kicad_pcb, LAM-RPI-DMX.kicad_sch]
2025-06-12 LAM-ZB-ROUTER: Revision A
    [LAM-ZB-ROUTER.kicad_pcb, LAM-ZB-ROUTER.kicad_sch]
2025-06-15 LAM-ZB-ROUTER: Rev B
    [LAM-ZB-ROUTER.kicad_pcb, LAM-ZB-ROUTER.kicad_sch]
2026-05-02 fix: 4i40 move to new library and fix minor bugs
    [main.c, modbus_config.h]
